JamesB-C/Mini_Rover/List3.param

ATC_SPEED_D,0.05
ATC_SPEED_D_FF,0
ATC_SPEED_FF,0
ATC_SPEED_FLTD,0
ATC_SPEED_FLTE,10
ATC_SPEED_FLTT,0
ATC_SPEED_I,0.5344411
ATC_SPEED_IMAX,1
ATC_SPEED_NEF,0
ATC_SPEED_NTF,0
ATC_SPEED_P,0.5344411
ATC_SPEED_PDMX,0
ATC_SPEED_SMAX,0
ATC_STR_ACC_MAX,120
ATC_STR_ANG_P,2
ATC_STR_RAT_D,0.05
ATC_STR_RAT_D_FF,0
ATC_STR_RAT_FF,0.7
ATC_STR_RAT_FLTD,2
ATC_STR_RAT_FLTE,10
ATC_STR_RAT_FLTT,2
ATC_STR_RAT_I,0.5344411
ATC_STR_RAT_IMAX,1
ATC_STR_RAT_MAX,120
ATC_STR_RAT_NEF,0
ATC_STR_RAT_NTF,0
ATC_STR_RAT_P,0.5344411
ATC_STR_RAT_PDMX,0
ATC_STR_RAT_SMAX,0
BATT_AMP_OFFSET,0
BATT_AMP_PERVLT,36.6
BATT_ARM_MAH,0
BATT_ARM_VOLT,0
BATT_CAPACITY,3300
BATT_CRT_MAH,0
BATT_CRT_VOLT,0
BATT_CURR_PIN,4
BATT_FS_CRT_ACT,0
BATT_FS_LOW_ACT,0
BATT_FS_VOLTSRC,0
BATT_LOW_MAH,0
BATT_LOW_TIMER,10
BATT_LOW_VOLT,0
BATT_MONITOR,4
BATT_OPTIONS,0
BATT_SERIAL_NUM,-1
BATT_VLT_OFFSET,0
BATT_VOLT_MULT,18.18
BATT_VOLT_PIN,8
BATT2_MONITOR,0
BATT3_MONITOR,0
BATT4_MONITOR,0
BATT5_MONITOR,0
BATT6_MONITOR,0
BATT7_MONITOR,0
BATT8_MONITOR,0
BATT9_MONITOR,0
FLTMODE_GCSBLOCK,0
FRAME_CLASS,1
FRAME_TYPE,0
INS_GYRO_FILTER,4
INS_HNTCH_ENABLE,0
MOT_PWM_FREQ,20
MOT_PWM_TYPE,0
MOT_SAFE_DISARM,0
MOT_SLEWRATE,100
MOT_SPD_SCA_BASE,1
MOT_STR_THR_MIX,1
MOT_THR_MAX,100
MOT_THR_MIN,0
MOT_THST_ASYM,1
MOT_THST_EXPO,0
MOT_VEC_ANGLEMAX,0
SERIAL0_BAUD,115
SERIAL0_PROTOCOL,2
SERIAL1_BAUD,57
SERIAL1_OPTIONS,0
SERIAL1_PROTOCOL,2
SERIAL2_BAUD,57
SERIAL2_OPTIONS,0
SERIAL2_PROTOCOL,2
SERIAL3_BAUD,230
SERIAL3_OPTIONS,0
SERIAL3_PROTOCOL,5
SERIAL4_BAUD,230
SERIAL4_OPTIONS,0
SERIAL4_PROTOCOL,5
SERIAL5_BAUD,57
SERIAL5_OPTIONS,0
SERIAL5_PROTOCOL,-1
SERIAL6_BAUD,421
SERIAL6_OPTIONS,0
SERIAL6_PROTOCOL,23
SERIAL7_BAUD,115
SERIAL7_OPTIONS,0
SERIAL7_PROTOCOL,42
SERIAL8_BAUD,115
SERIAL8_OPTIONS,0
SERIAL8_PROTOCOL,-1
SERVO1_FUNCTION,26
SERVO1_MAX,2011
SERVO1_MIN,988
SERVO1_REVERSED,0
SERVO1_TRIM,1500
SERVO2_FUNCTION,70
SERVO2_MAX,2011
SERVO2_MIN,988
SERVO2_REVERSED,0
SERVO2_TRIM,1500
SERVO3_FUNCTION,0
SERVO3_MAX,1900
SERVO3_MIN,1100
SERVO3_REVERSED,0
SERVO3_TRIM,1500
SERVO4_FUNCTION,0
SERVO4_MAX,1900
SERVO4_MIN,1100
SERVO4_REVERSED,0
SERVO4_TRIM,1500
SERVO5_FUNCTION,0
SERVO5_MAX,1900
SERVO5_MIN,1100
SERVO5_REVERSED,0
SERVO5_TRIM,1500
SERVO6_FUNCTION,0
SERVO6_MAX,1900
SERVO6_MIN,1100
SERVO6_REVERSED,0
SERVO6_TRIM,1500
SERVO7_FUNCTION,0
SERVO7_MAX,1900
SERVO7_MIN,1100
SERVO7_REVERSED,0
SERVO7_TRIM,1500
SERVO8_FUNCTION,0
SERVO8_MAX,1900
SERVO8_MIN,1100
SERVO8_REVERSED,0
SERVO8_TRIM,1500
SERVO9_FUNCTION,0
SERVO9_MAX,1900
SERVO9_MIN,1100
SERVO9_REVERSED,0
SERVO9_TRIM,1500
