JamesB-C/Mini_Rover/(commit log)

2026-06-07 Create Arduino_Uno_Code
2026-06-08 Add files via upload
    List of parameters as of June 8th
    [List1.param]
2026-06-18 June 18th Parameters
    [List3.param]
